PantoYT/wled-controller/enclosure/rev1/renders/enclosure-base-outputs.png

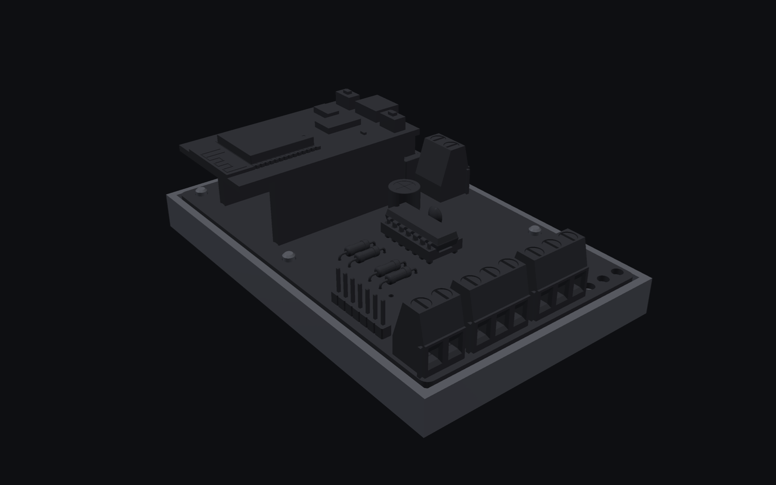
enclosure/rev1/renders/enclosure-base-outputs.png
