PantoYT/wled-controller/enclosure/rev1/renders/enclosure-outputs.png

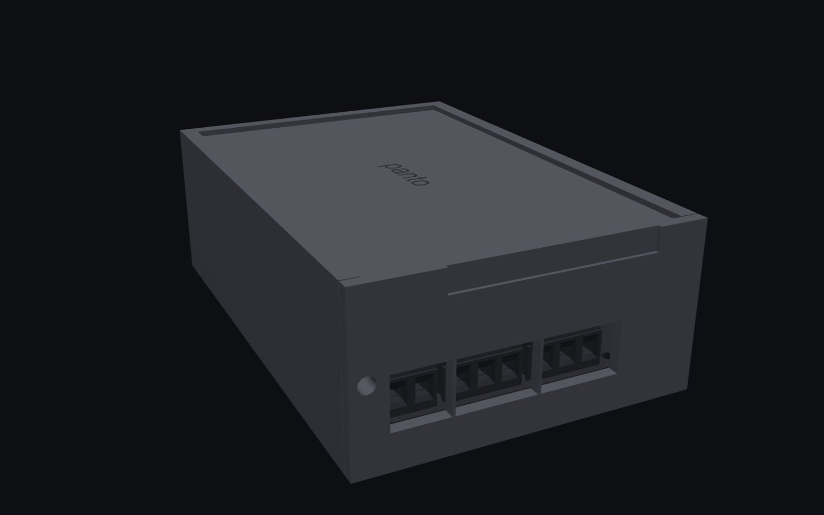
enclosure/rev1/renders/enclosure-outputs.png
