PantoYT/wled-controller/enclosure/rev1/renders/enclosure-top.png

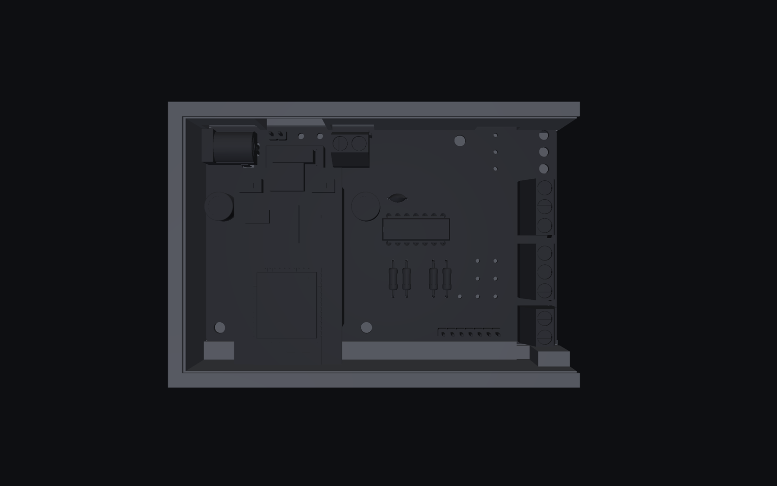
enclosure/rev1/renders/enclosure-top.png
