PantoYT/wled-controller/enclosure/wall/renders/wall-bottom.png

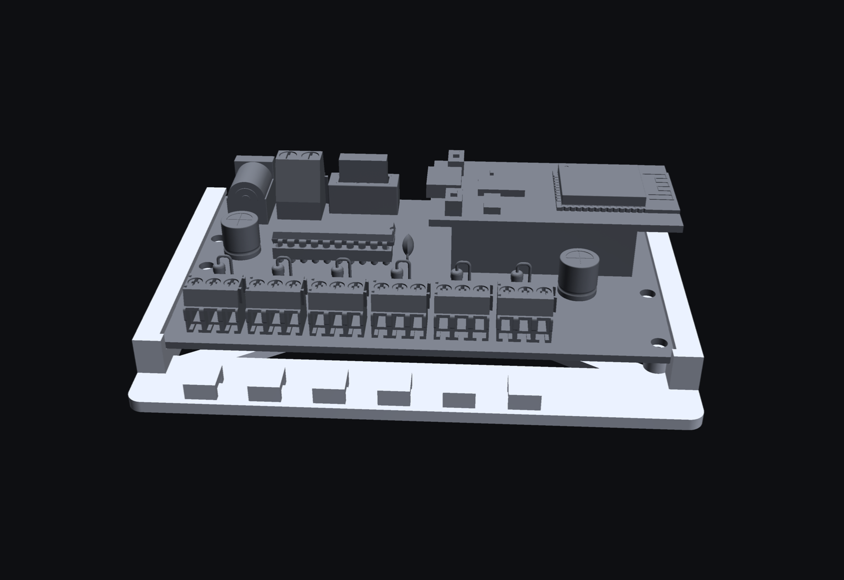
enclosure/wall/renders/wall-bottom.png
