PantoYT/wled-controller/enclosure/wall/renders/wall-front.png

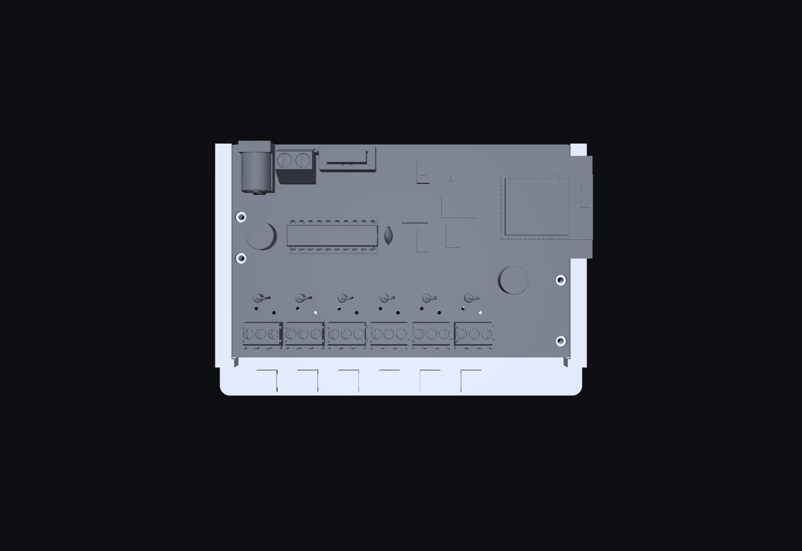
enclosure/wall/renders/wall-front.png
