PantoYT/wled-controller/rev2/renders/v2-wall-iso.png

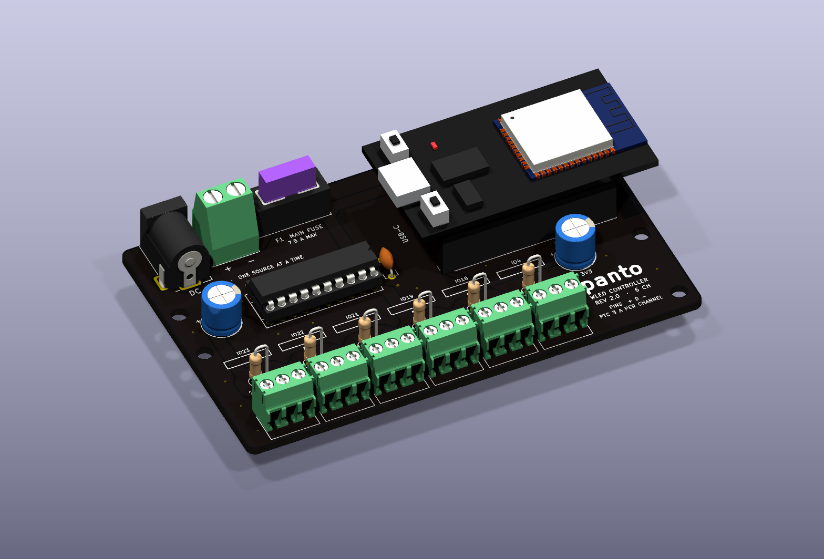
rev2/renders/v2-wall-iso.png
