PantoYT/wled-controller/purchases/wled-costs.xlsx

Sheet: v1 cost
Source | Item | Symbol | Qty | Unit PLN | Line PLN | Link | Note
JLCPCB | PCB rev 1.0, 2 layers, 5 pcs, shipping included |  | 5 |  | 30.00 | https://jlcpcb.com/ | paid
Allegro | ESP32-WROOM-32 USB-C CH340 4 MB |  | 1 |  | 25.00 | https://allegro.pl/oferta/mikrokontroler-esp-wroom-32-esp32-usb-c-ch340-wifi-bt-esp-32-4mb-do-arduino-12575360436 | paid
Allegro | WS2812B 5 V, 30 LED/m, IP30, black PCB |  | 4 |  | 40.00 | https://allegro.pl/oferta/1m-tasma-ws2812b-argb-5v-30-diod-m-ip30-smart-magic-led-czarne-pcb-18922593462 | paid, ~; 4 m = 120 LEDs, 72 used
Allegro | JST SM 3-pin pair (plug + socket) |  | 1 |  | 3.50 | https://allegro.pl/oferta/konektory-para-gniazdo-wtyk-jst-sm-3-pin-do-tasm-ws2812b-ws2811-rgb-17680312115 | paid
TME | 74HCT125 buffer DIP-14 | CD74HCT125E | 2 | 4.68 |  | https://www.tme.eu/pl/katalog/?search=CD74HCT125E | 1 on board #1, 1 spare
TME | DIP-14 socket | 1-2199298-3 | 1 | 1.27 |  | https://www.tme.eu/pl/katalog/?search=1-2199298-3
TME | Female header 1x40 (cut to 2x 1x15) | ZL262-40SG | 2 | 2.23 |  | https://www.tme.eu/pl/katalog/?search=ZL262-40SG
TME | 100 nF ceramic THT | CC-104/100 | 100 | 0.17 |  | https://www.tme.eu/pl/katalog/?search=CC-104%2F100 | TME minimum 100
TME | 100 ohm 0.25 W | CF1/4W-100R | 100 | 0.04 |  | https://www.tme.eu/pl/katalog/?search=CF1%2F4W-100R | TME minimum 100
TME | Mini blade fuse holder | KEYS3568 | 1 | 4.77 |  | https://www.tme.eu/pl/katalog/?search=KEYS3568
TME | Mini blade fuse 3 A | 0297003.WXNV | 2 | 1.71 |  | https://www.tme.eu/pl/katalog/?search=0297003.WXNV
TME | DC jack 5.5/2.1 THT | PC-GK2.1 | 3 | 1.75 |  | https://www.tme.eu/pl/katalog/?search=PC-GK2.1 | TME minimum 3
TME | Screw terminal 5.08 mm 3-pole | TB-5.08-P-3P/BL | 2 | 1.97 |  | https://www.tme.eu/pl/katalog/?search=TB-5.08-P-3P%2FBL
TME | Screw terminal 5.08 mm 2-pole | TB-5.08-P-2P/BL | 5 | 1.32 |  | https://www.tme.eu/pl/katalog/?search=TB-5.08-P-2P%2FBL | TME minimum 5
TME | Male header 1x40 | ZL201-40G | 10 | 1.42 |  | https://www.tme.eu/pl/katalog/?search=ZL201-40G | TME minimum 10
own | 1000 uF 16 V electrolytic (owned) | EEUFR1C102L | 2 | 0.00 |  | https://www.tme.eu/pl/katalog/?search=EEUFR1C102L | already owned; 3.95 each at TME
TME | Shipping |  | 1 |  |  |  | FILL IN from the invoice
Allegro | Shipping |  | 1 |  |  |  | FILL IN
 | TOTAL (fills in when shipping is entered)
 | TME subtotal
 | TME prices: catalogue on 2026-10-19 via API, not the invoice. Allegro/JLC: what Panto paid.

Sheet: v2 phi 6ch
Ref | Item | Symbol | Need | In inventory | Buy | Unit PLN | Line PLN | Link | Note
PCB | PCB rev 2.0 phi 100x61.8, 5 pcs, shipping included |  | 1 | 0 | 1 | 30.00 |  | https://jlcpcb.com/ | estimate = what rev 1.0 cost; upload v2 gerbers
U2/U3 module | ESP32-WROOM-32 USB-C CH340 30-pin |  | 1 | 0 | 1 | 25.00 |  | https://allegro.pl/oferta/mikrokontroler-esp-wroom-32-esp32-usb-c-ch340-wifi-bt-esp-32-4mb-do-arduino-12575360436 | inventory has no spare ESP32
U1 | 74HCT245 DIP-20 (HCT, not HC) | SN74HCT245N | 1 | 0 | 1 | 2.70 |  | https://www.tme.eu/pl/katalog/?search=SN74HCT245N
 | DIP-20 socket | 1-2199298-6 | 1 | 0 | 1 | 2.29 |  | https://www.tme.eu/pl/katalog/?search=1-2199298-6
F1 | Mini blade fuse holder | KEYS3568 | 1 | 0 | 1 | 4.77 |  | https://www.tme.eu/pl/katalog/?search=KEYS3568 | rev 1.0 one is soldered on board #1
F1 | Mini blade fuse 7.5 A max | 029707.5WXNV | 1 | 1 | 2 | 1.71 |  | https://www.tme.eu/pl/katalog/?search=029707.5WXNV | spare 3 A from inventory works for a small load
F11-F16 | Polyfuse 3 A hold, 16 V | RG300-16 | 6 | 0 | 6 | 1.36 |  | https://www.tme.eu/pl/katalog/?search=RG300-16
J11-J16 | Screw terminal 3.5 mm 3-pole | XY302R-3P-3.5-GN | 6 | 0 | 6 | 1.29 |  | https://www.tme.eu/pl/katalog/?search=XY302R-3P-3.5-GN | check holes vs Phoenix footprint
J21-J26 | JST XH 3-pin socket | B3B-XH-A | 6 | 0 | 6 | 0.50 |  | https://www.tme.eu/pl/katalog/?search=B3B-XH-A
R1-R6 | 100 ohm 0.25 W | CF1/4W-100R | 6 | 96 | 0 | 0.04 |  | https://www.tme.eu/pl/katalog/?search=CF1%2F4W-100R | from inventory
C1, C2 | 1000 uF 16 V, D8 P5 | EEUFR1C102L | 2 | 2 | 0 | 3.95 |  | https://www.tme.eu/pl/katalog/?search=EEUFR1C102L | from inventory
C3 | 100 nF ceramic | CC-104/100 | 1 | 99 | 0 | 0.17 |  | https://www.tme.eu/pl/katalog/?search=CC-104%2F100 | from inventory
J1 | DC jack 5.5/2.1 | PC-GK2.1 | 1 | 2 | 0 | 1.75 |  | https://www.tme.eu/pl/katalog/?search=PC-GK2.1 | from inventory
J2 | Screw terminal 5.08 mm 2-pole | TB-5.08-P-2P/BL | 1 | 3 | 0 | 1.32 |  | https://www.tme.eu/pl/katalog/?search=TB-5.08-P-2P%2FBL | from inventory
U2, U3 | Female header 1x40 (cut to 2x 1x15) | ZL262-40SG | 2 | 0 | 2 | 2.23 |  | https://www.tme.eu/pl/katalog/?search=ZL262-40SG | rev 1.0 spare not in inventory: CHECK drawer, then set buy to 0
strips | JST SM to XH lead, or wire straight into the terminal |  | 6 | 0 | 0 |  |  |  | not at TME; optional
 | TME shipping |  | 1 | 0 | 1 |  |  |  | FILL IN
 | TO BUY (PCB + ESP32 + TME parts)
 | Value taken from inventory
 | In inventory = quantity in parts-inventory/inventory.xlsx on 2026-10-19. Strip not included (48 LEDs left over).

Sheet: leftovers
Item (inventory.xlsx) | Qty
WLED controller PCB v1, bare | 4
WS2812B strip, leftover | 48
100 ohm | 96
Ceramic 100 nF (104) | 99
Electrolytic 1000 uF 16 V | 2
DC barrel jack | 2
Screw terminal, 2 poles | 3
Mini blade fuse 3 A | 1
CD74HCT125E
DIP-14 socket
Male pin header 1x16 | 9

Sheet: files
What | Where
v1 gerbers | E:\Pliki\Projects\wled-controller\wled-controller-gerbers.zip
v2 phi gerbers | E:\Pliki\Projects\wled-controller\v2\wled-controller-v2-phi-gerbers.zip
v1 TME quickbuy | E:\Pliki\Projects\wled-controller\quickbuy-v1.txt
v2 TME quickbuy | E:\Pliki\Projects\wled-controller\v2\quickbuy-v2-phi.txt
JLCPCB order page | https://jlcpcb.com/
TME quick buy | https://www.tme.eu/pl/ (koszyk -> szybkie zakupy / import listy)
