PantoYT/wled-controller/rev1/BOM.md

# Bill of materials

TME symbols and prices (PLN gross) as seen in the TME cart on 2026-10-02.

| Ref | Part | TME symbol | Qty to order | Note |
|---|---|---|---|---|
| U1 | 74HCT125 buffer, DIP-14 (HCT/AHCT only, not HC) | `CD74HCT125E` | 2 | 4.69 each; one spare |
| — | DIP-14 socket | `1-2199298-3` | 1 | 1.28 |
| U2, U3 | Female header 1×40, cut into two 1×15 | `ZL262-40SG` | 2 (minimum) | 1.86 each, 10 890 in stock; true 1×15 parts at TME are 7 PLN+ or 1000-piece MOQ |
| J4, J16 | Male pin header 1×40 | `DS1021-1*40SF11-B` | 10 (minimum) | break into 1×2 and 1×7 |
| C1, C2 | 1000 µF 16 V electrolytic, Ø8 mm, 5 mm pitch | — | 2 | already owned |
| C3 | 100 nF ceramic, THT, 5 mm pitch | `CC-104/100` | 100 (minimum) | |
| R1–R4 | 100 Ω 0.25 W carbon film | `CF1/4W-100R` | 100 (minimum) | |
| F1 | Mini blade fuse holder | `KEYS3568` | 1 | |
| — | Mini blade fuse 3 A | `0297003.WXNV` | 2 | Littelfuse MINI |
| J1 | DC jack 5.5/2.1 mm, right angle, THT | `PC-GK2.1` | 3 (minimum) | Out of stock on 2026-10-02, TME expects 2026-10-21. The footprint is made for this exact part (`footprints/wled.pretty`). |
| J6, J7 | Screw terminal 5.08 mm, 3-pole | `TB-5.08-P-3P/BL` | 2 | |
| J2, J8 | Screw terminal 5.08 mm, 2-pole | `TB-5.08-P-2P/BL` | 2+ | |
| J5 | JST SM 3-pin pigtail pair | — | 1 | not at TME; Allegro |

## PCB

JLCPCB: 5 boards, 2 layers, up to 100 × 100 mm, standard options: 2 USD. Mask colour does
not change the price. Shipping to Poland and import VAT come on top.
