PantoYT/wled-controller/3d/fuse_mini.step

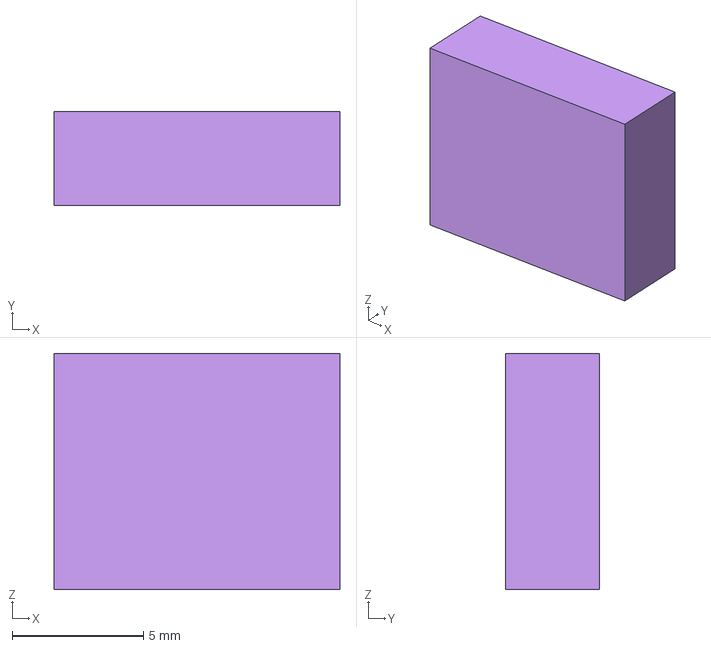
[picture p20: CAD file, 2026-10-20]
3d/fuse_mini.step
10.9 x 3.60 x 9.00 mm
