PantoYT/wled-controller/enclosure/rev1/lid.stl

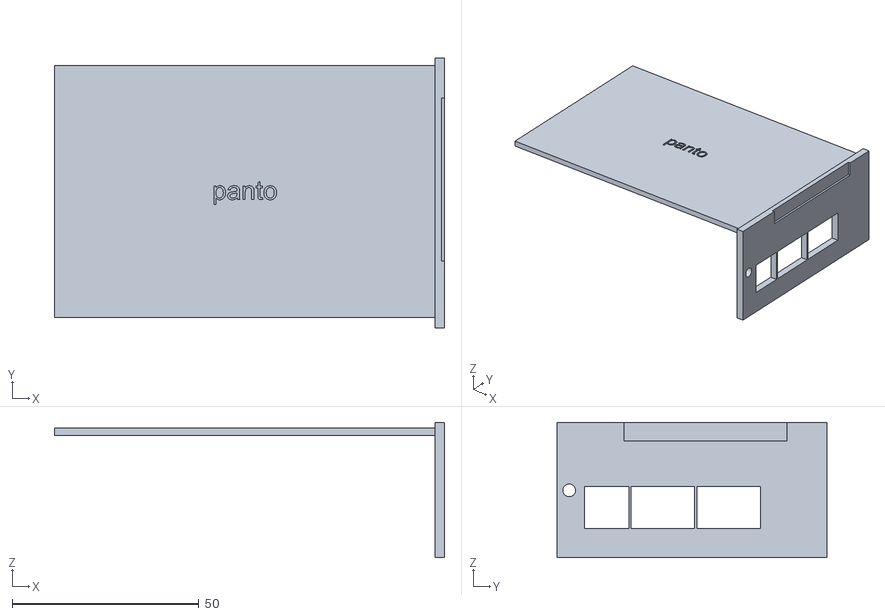
[picture p21: CAD file, 2026-10-20]
enclosure/rev1/lid.stl
104.5 x 72.4 x 36.2
