PantoYT/wled-controller/enclosure/wall/wall-fit-test.stl

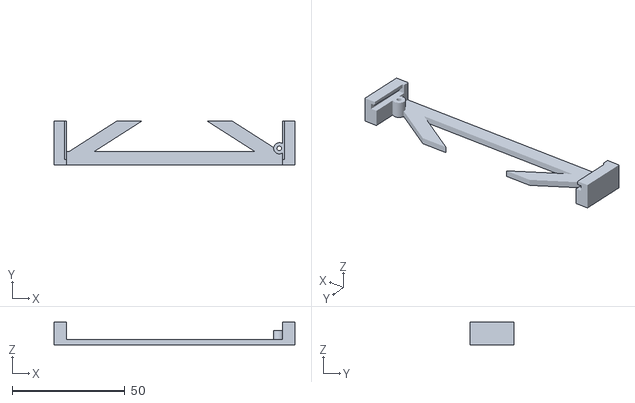
[picture p22: CAD file, 2026-10-29]
enclosure/wall/wall-fit-test.stl
107.0 x 19.4 x 10.0
