PantoYT/wled-controller/rev2/wled-controller-v2-wall.step

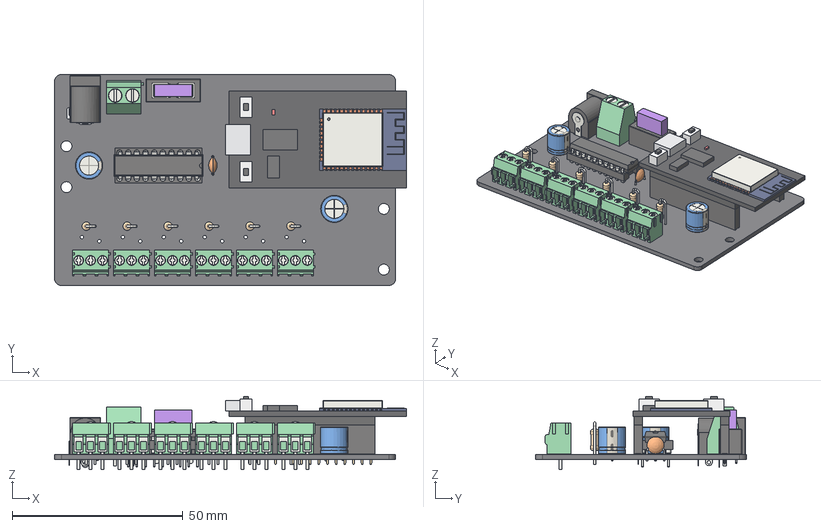
[picture p23: CAD file, 2026-10-20]
rev2/wled-controller-v2-wall.step
103.2 x 61.8 x 21.4 mm
BarrelJack_Horizontal
PinSocket_1x15_P2.54mm_Vertical x 2
TerminalBlock_Phoenix_PT-1,5-3-3.5-H_1x03_P3.50mm_Horizontal x 6
CP_Radial_D80mm_P500mm x 2
header_spacer x 2
devkit_pcb
ESP32-WROOM-32
usb_c
button x 2
button_cap x 2
ch340
ldo
led
DIP_20_W762mm_Socket
DIP-20_W7.62mm
A_Keystone_3568
fuse_mini
R_Axial_DIN0207_L63mm_D25mm_P254mm_Vertical x 6
C_Disc_D50mm_W25mm_P500mm
TerminalBlock_Phoenix_MKDS-1,5-2-5.08_1x02_P5.08mm_Horizontal
wled-controller-v2-wall_PCB
