PantoYT/wled-controller/3d/header_spacer.step

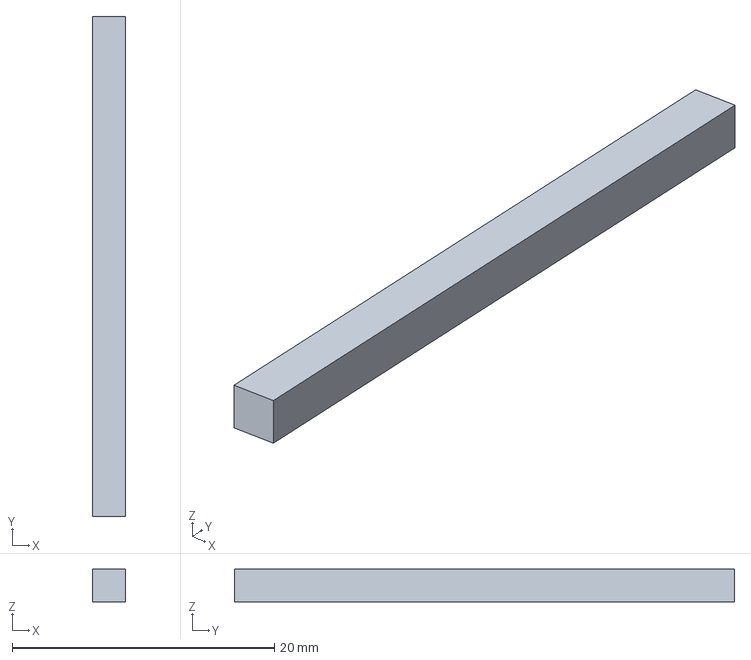
[picture p24: CAD file, 2026-10-20]
3d/header_spacer.step
2.54 x 38.1 x 2.50 mm
