PantoYT/wled-controller/enclosure/rev1/body.stl

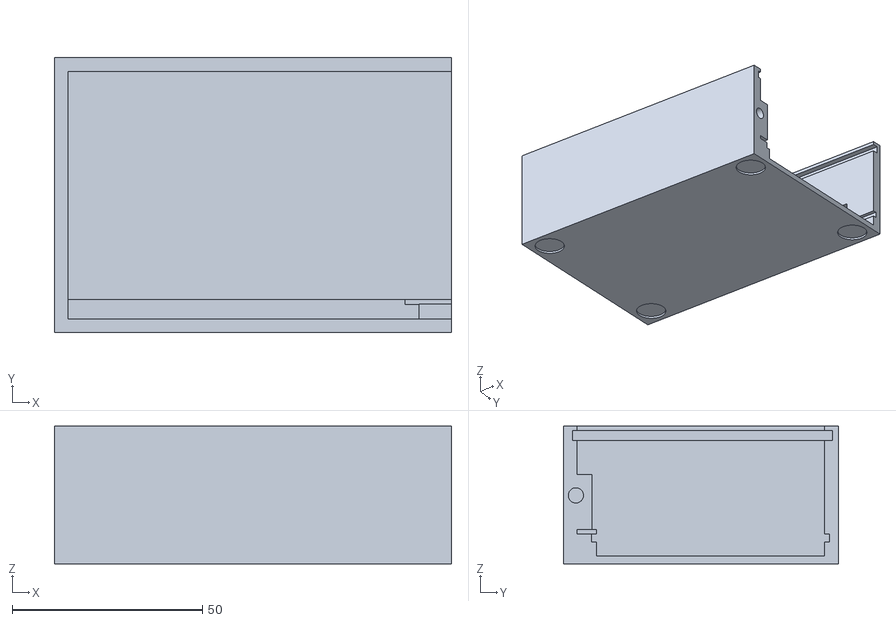
[picture p25: CAD file, 2026-10-20]
enclosure/rev1/body.stl
104.4 x 72.4 x 36.2
