PantoYT/wled-controller/enclosure/wall/wall.step

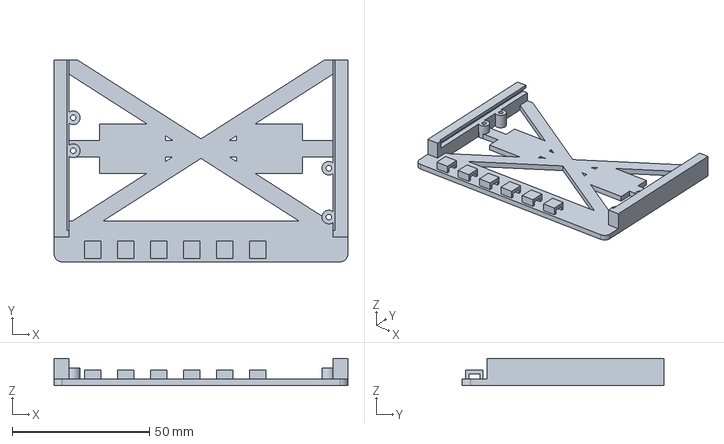
[picture p26: CAD file, 2026-10-29]
enclosure/wall/wall.step
107.0 x 73.5 x 10.0 mm
