PantoYT/wled-controller/3d/ch340.step

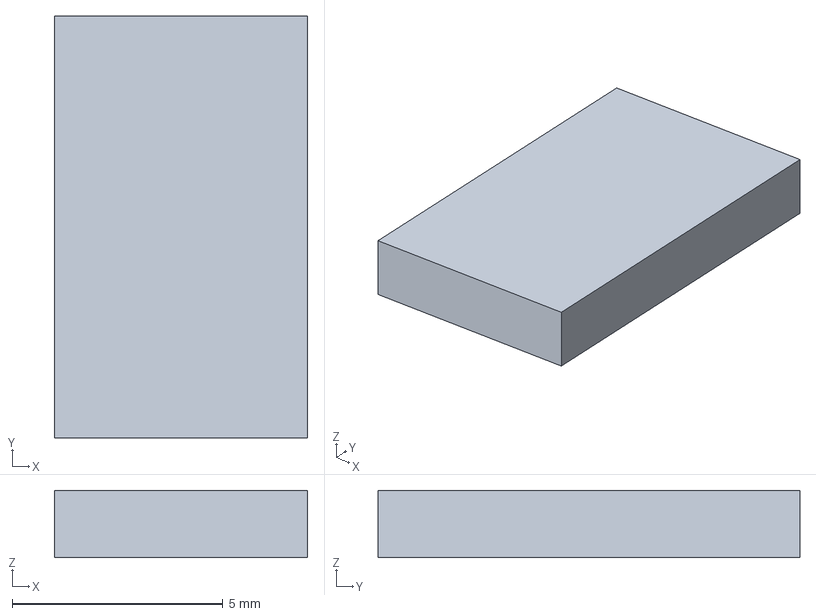
[picture p27: CAD file, 2026-10-20]
3d/ch340.step
6.00 x 10.0 x 1.60 mm
