PantoYT/wled-controller/enclosure/rev1/enclosure.step

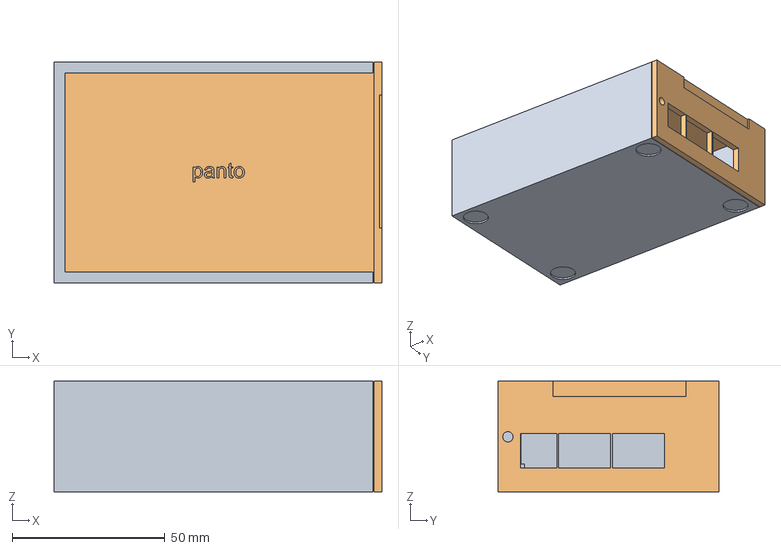
[picture p28: CAD file, 2026-10-20]
enclosure/rev1/enclosure.step
107.3 x 72.4 x 36.2 mm
