PantoYT/wled-controller/3d/button_cap.step

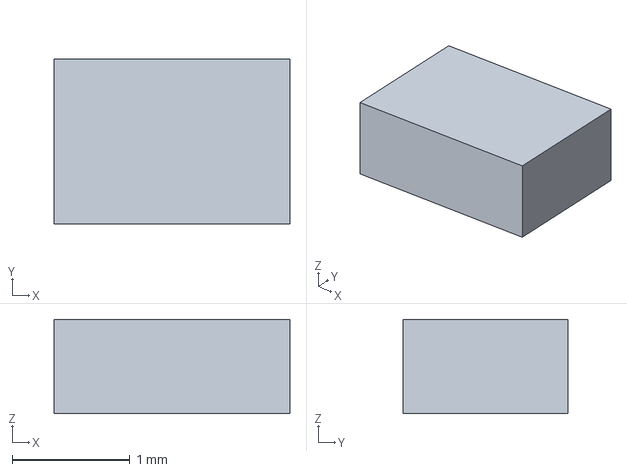
[picture p29: CAD file, 2026-10-20]
3d/button_cap.step
2.00 x 1.40 x 0.8 mm
