PantoYT/wled-controller/enclosure/rev1/fit-test-lid.stl

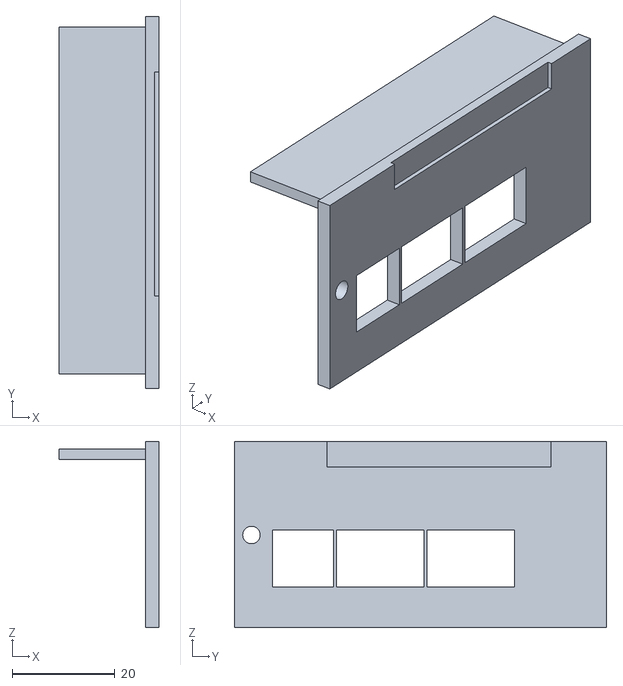
[picture p30: CAD file, 2026-10-20]
enclosure/rev1/fit-test-lid.stl
19.4 x 72.4 x 36.2
