PantoYT/wled-controller/3d/ldo.step

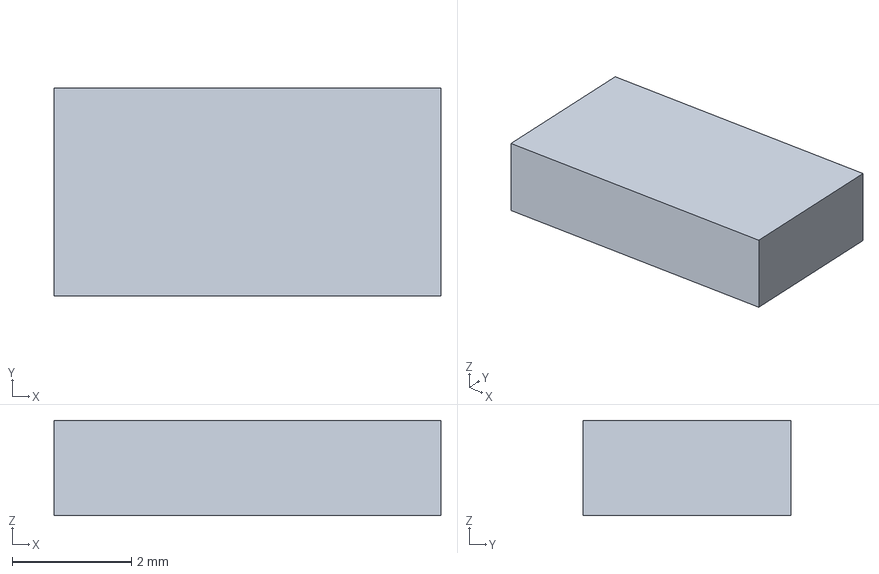
[picture p31: CAD file, 2026-10-20]
3d/ldo.step
6.50 x 3.50 x 1.60 mm
