PantoYT/wled-controller/enclosure/rev1/base.step

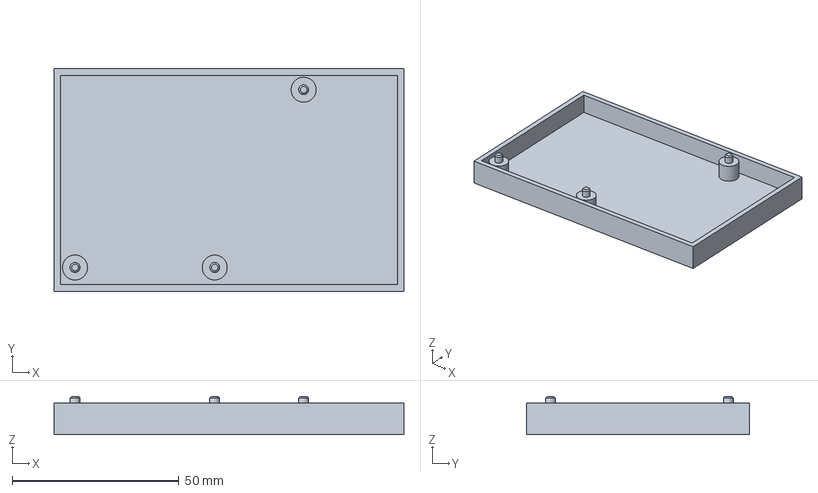
[picture p32: CAD file, 2026-10-20]
enclosure/rev1/base.step
105.0 x 66.8 x 11.5 mm
