PantoYT/wled-controller/3d/led.step

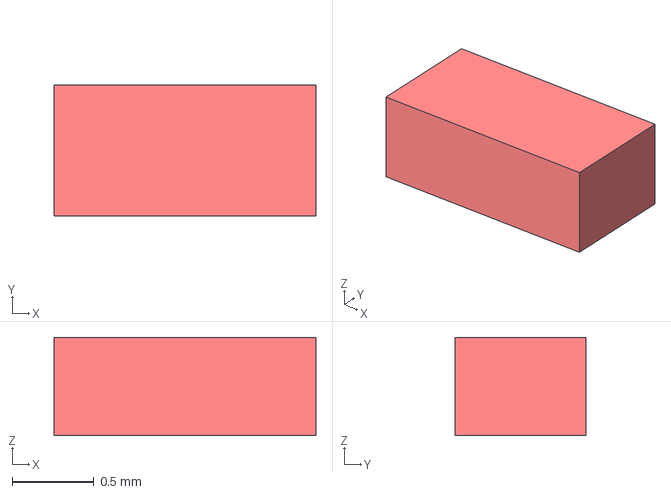
[picture p33: CAD file, 2026-10-20]
3d/led.step
1.60 x 0.8 x 0.6 mm
