PantoYT/wled-controller/enclosure/rev1/fit-test-body.stl

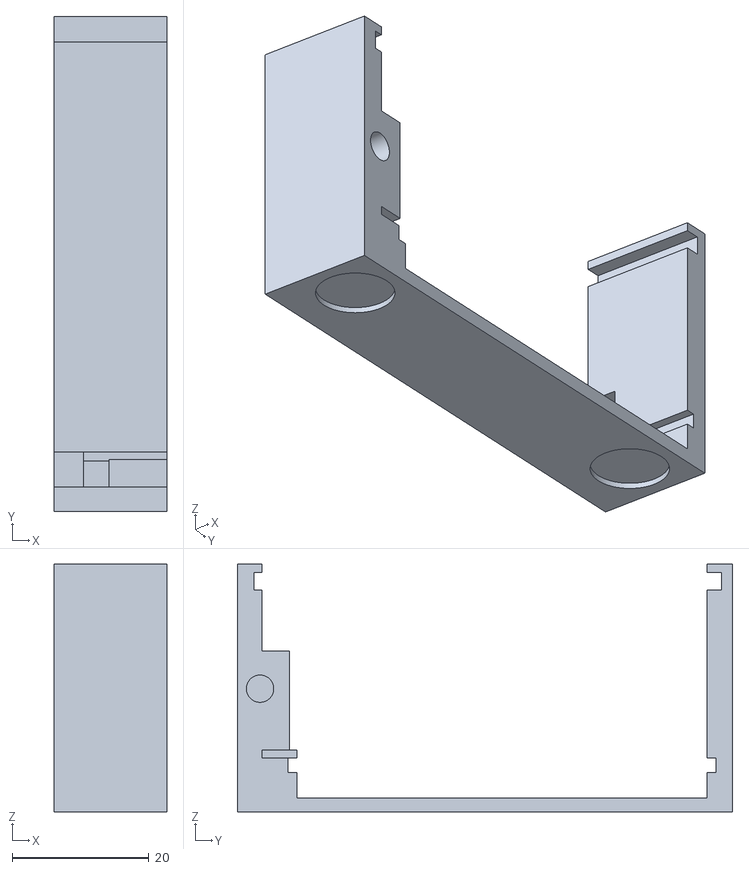
[picture p34: CAD file, 2026-10-20]
enclosure/rev1/fit-test-body.stl
16.5 x 72.4 x 36.2
