PantoYT/wled-controller/3d/devkit_pcb.step

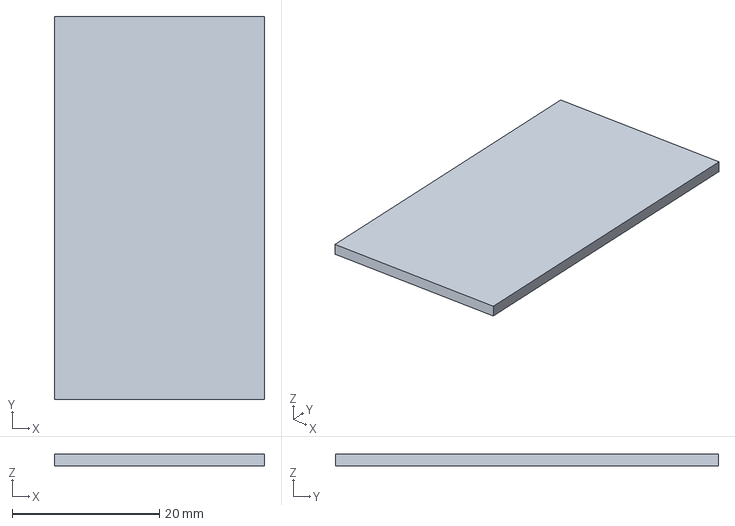
[picture p35: CAD file, 2026-10-20]
3d/devkit_pcb.step
28.5 x 52.0 x 1.60 mm
