PantoYT/wled-controller/3d/usb_c.step

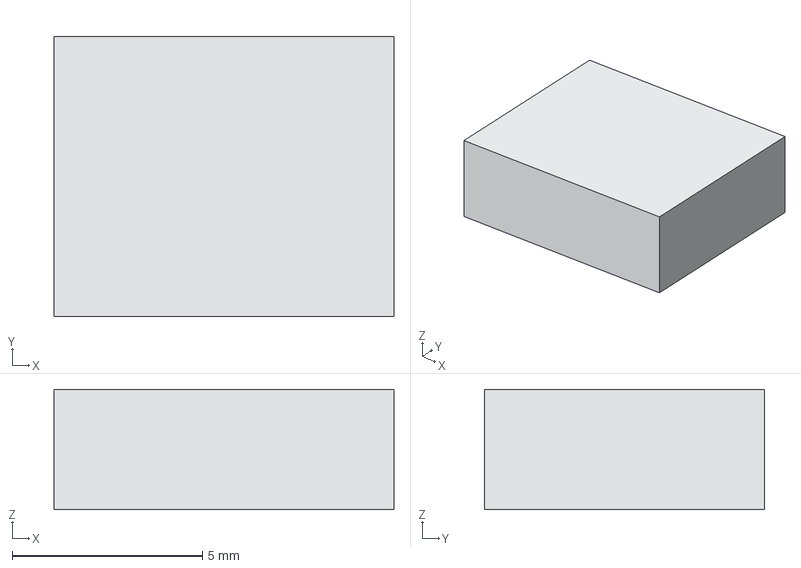
[picture p36: CAD file, 2026-10-20]
3d/usb_c.step
8.94 x 7.35 x 3.16 mm
