PantoYT/wled-controller/3d/button.step

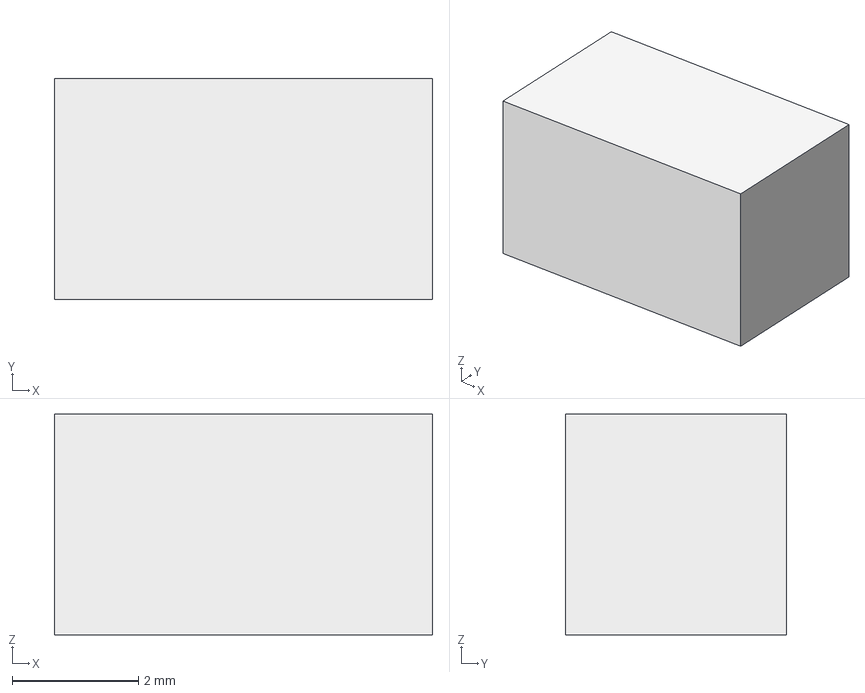
[picture p37: CAD file, 2026-10-20]
3d/button.step
6.00 x 3.50 x 3.50 mm
