PantoYT/wled-controller/(list of files, cad)

Other CAD files:
enclosure/rev1/base.3mf
enclosure/rev1/base.stl
enclosure/wall/wall.stl
rev1/wled-controller.step
rev2/old-variants/wled-controller-v2-phi4.step
