PantoYT/wled-controller/rev2/old-variants/wled-controller-v2-100.kicad_pcb

## KiCad design rev2/old-variants/wled-controller-v2-100.kicad_pcb (2026-10-20, an earlier design)

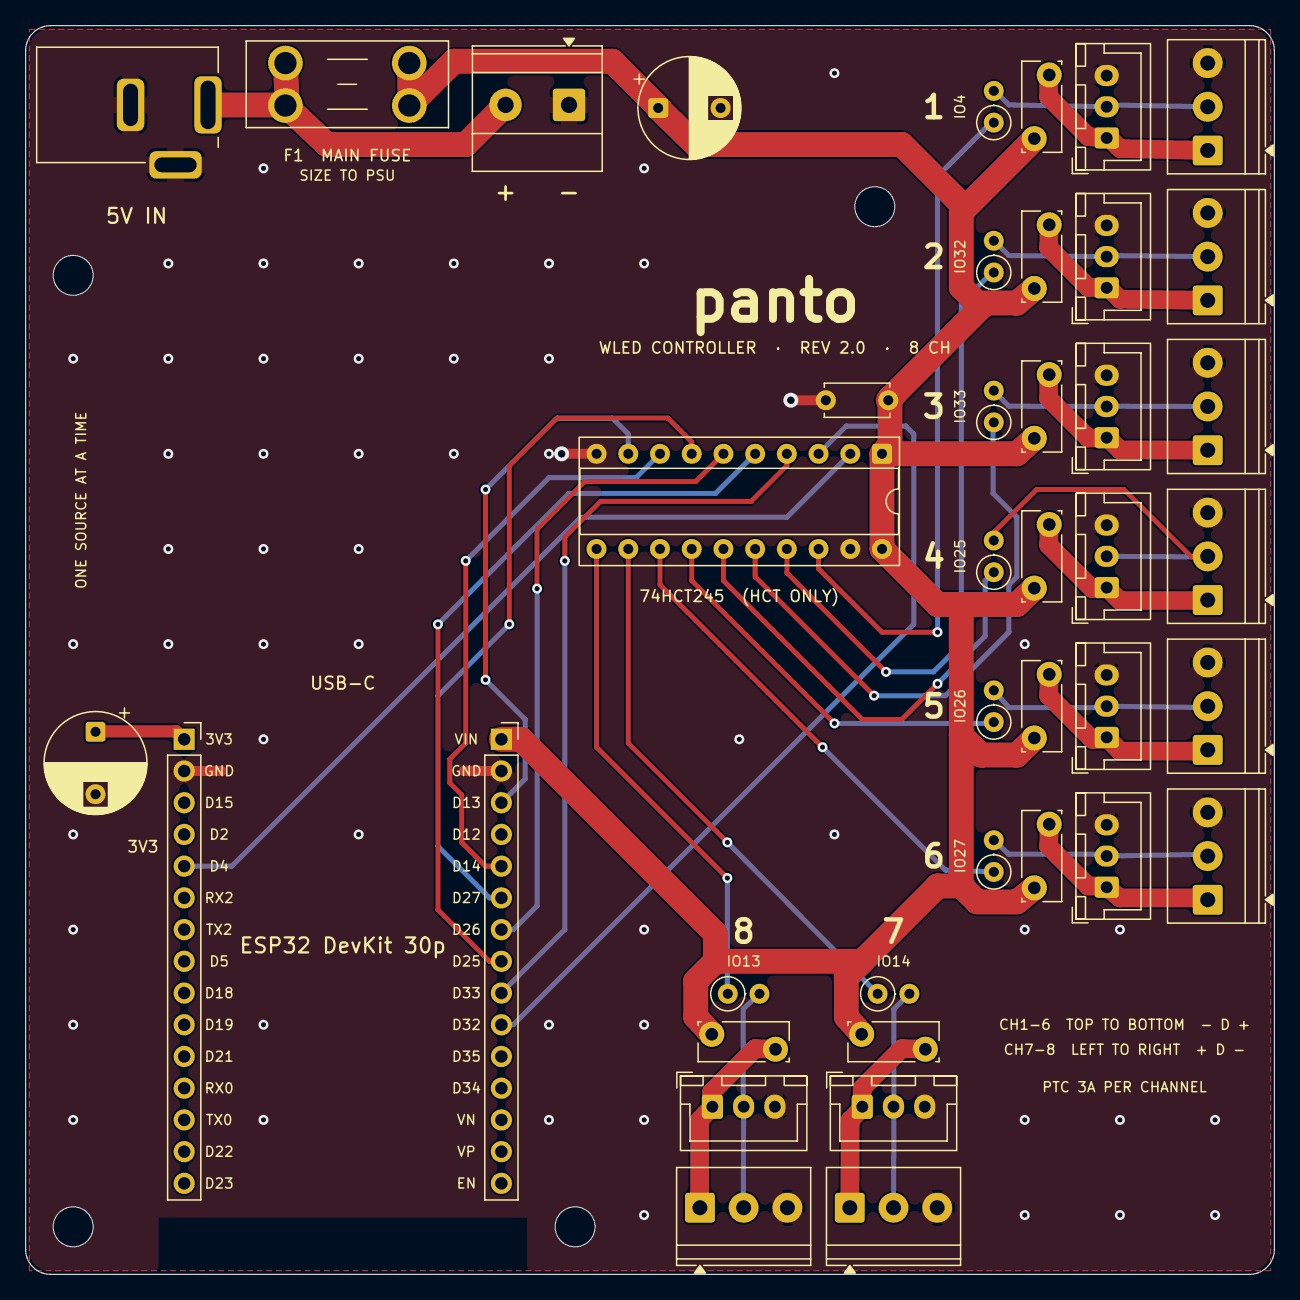
[picture p39: board wled-controller-v2-100.kicad_pcb from above]

Board: 2 copper layers, 100.0 x 100.0 mm, 46 parts (0 on the bottom side), 36 nets.

Parts:
C1, C2: 1000uF 16V; CP_Radial_D8.0mm_P5.00mm
C3: 100nF; C_Disc_D5.0mm_W2.5mm_P5.00mm
ESP1: ESP32 DevKit (3D only)
F1: Mini blade fuse, size to the PSU; Fuseholder_Blade_Mini_Keystone_3568
F11, F12, F13, F14, F15, F16, F17, F18: MF-RG300 3A; Fuse_Bourns_MF-RG300
H1, H2, H3, H4: M3; MountingHole_3.2mm_M3
J1: PC-GK2.1; DC_Jack_Ninigi_PC-GK2.1
J2: Screw 2p IN; TerminalBlock_Phoenix_MKDS-1,5-2-5.08_1x02_P5.08mm_Horizont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
J11: Screw CH1; TerminalBlock_Phoenix_PT-1,5-3-3.5-H_1x03_P3.50mm_Horizontal
J12: Screw CH2; TerminalBlock_Phoenix_PT-1,5-3-3.5-H_1x03_P3.50mm_Horizontal
J13: Screw CH3; TerminalBlock_Phoenix_PT-1,5-3-3.5-H_1x03_P3.50mm_Horizontal
J14: Screw CH4; TerminalBlock_Phoenix_PT-1,5-3-3.5-H_1x03_P3.50mm_Horizontal
J15: Screw CH5; TerminalBlock_Phoenix_PT-1,5-3-3.5-H_1x03_P3.50mm_Horizontal
J16: Screw CH6; TerminalBlock_Phoenix_PT-1,5-3-3.5-H_1x03_P3.50mm_Horizontal
J17: Screw CH7; TerminalBlock_Phoenix_PT-1,5-3-3.5-H_1x03_P3.50mm_Horizontal
J18: Screw CH8; TerminalBlock_Phoenix_PT-1,5-3-3.5-H_1x03_P3.50mm_Horizontal
J21: JST-XH CH1; JST_XH_B3B-XH-A_1x03_P2.50mm_Vertical
J22: JST-XH CH2; JST_XH_B3B-XH-A_1x03_P2.50mm_Vertical
J23: JST-XH CH3; JST_XH_B3B-XH-A_1x03_P2.50mm_Vertical
J24: JST-XH CH4; JST_XH_B3B-XH-A_1x03_P2.50mm_Vertical
J25: JST-XH CH5; JST_XH_B3B-XH-A_1x03_P2.50mm_Vertical
J26: JST-XH CH6; JST_XH_B3B-XH-A_1x03_P2.50mm_Vertical
J27: JST-XH CH7; JST_XH_B3B-XH-A_1x03_P2.50mm_Vertical
J28: JST-XH CH8; JST_XH_B3B-XH-A_1x03_P2.50mm_Vertical
R1, R2, R3, R4, R5, R6, R7, R8: 100R; R_Axial_DIN0207_L6.3mm_D2.5mm_P2.54mm_Vertical
U1: 74HCT245; DIP-20_W7.62mm_Socket
U2, U3: ESP32 socket; PinSocket_1x15_P2.54mm_Vertical

Connections:
+3V3: C2.1, U2.1
+5V: C1.1, C3.1, F1.2, F11.1, F12.1, F13.1, F14.1, F15.1, F16.1, F17.1, F18.1, U1.1, U1.20, U3.1
DATA1: J11.2, J21.2, R1.2
DATA2: J12.2, J22.2, R2.2
DATA3: J13.2, J23.2, R3.2
DATA4: J14.2, J24.2, R4.2
DATA5: J15.2, J25.2, R5.2
DATA6: J16.2, J26.2, R6.2
DATA7: J17.2, J27.2, R7.2
DATA8: J18.2, J28.2, R8.2
GND: C1.2, C2.2, C3.2, J1.2, J1.3, J2.1, J11.3, J12.3, J13.3, J14.3, J15.3, J16.3, J17.3, J18.3, J21.3, J22.3, J23.3, J24.3, J25.3, J26.3, J27.3, J28.3, U1.10, U1.19, U2.2, U3.2
IO_CH1: U1.2, U2.5
IO_CH2: U1.3, U3.10
IO_CH3: U1.4, U3.9
IO_CH4: U1.5, U3.8
IO_CH5: U1.6, U3.7
IO_CH6: U1.7, U3.6
IO_CH7: U1.8, U3.5
IO_CH8: U1.9, U3.3
OUT1_RAW: R1.1, U1.18
OUT2_RAW: R2.1, U1.17
OUT3_RAW: R3.1, U1.16
OUT4_RAW: R4.1, U1.15
OUT5_RAW: R5.1, U1.14
OUT6_RAW: R6.1, U1.13
OUT7_RAW: R7.1, U1.12
OUT8_RAW: R8.1, U1.11
VIN_RAW: F1.1, J1.1, J2.2
V_CH1: F11.2, J11.1, J21.1
V_CH2: F12.2, J12.1, J22.1
V_CH3: F13.2, J13.1, J23.1
V_CH4: F14.2, J14.1, J24.1
V_CH5: F15.2, J15.1, J25.1
V_CH6: F16.2, J16.1, J26.1
V_CH7: F17.2, J17.1, J27.1
V_CH8: F18.2, J18.1, J28.1
