PantoYT/wled-controller/rev1/wled-controller.unrouted.kicad_pcb

## KiCad design rev1/wled-controller.unrouted.kicad_pcb (2026-10-20, an earlier design)

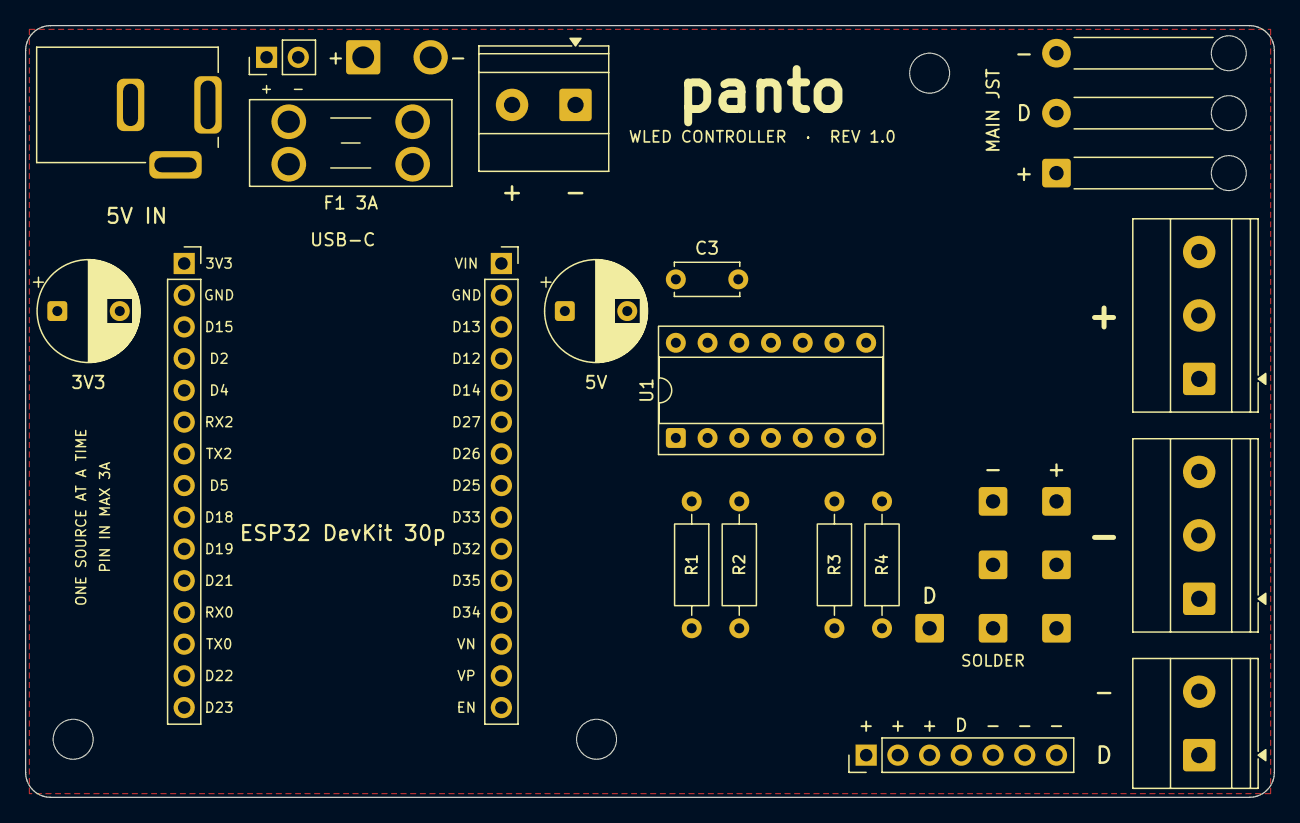
[picture p40: board wled-controller.unrouted.kicad_pcb from above]

Board: 2 copper layers, 100.0 x 61.8 mm, 31 parts (0 on the bottom side), 13 nets, no tracks yet.

Parts:
C1, C2: 1000uF 16V; CP_Radial_D8.0mm_P5.00mm
C3: 100nF; C_Disc_D5.0mm_W2.5mm_P5.00mm
ESP1: ESP32 DevKit (3D only)
F1: Fuse 3A (mini blade); Fuseholder_Blade_Mini_Keystone_3568
H1, H2, H3: M3; MountingHole_3.2mm_M3
J1: PC-GK2.1; DC_Jack_Ninigi_PC-GK2.1
J2: Screw 2p IN; TerminalBlock_Phoenix_MKDS-1,5-2-5.08_1x02_P5.08mm_Horizont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
J3: Solder IN; SolderWire-1sqmm_1x02_P5.4mm_D1.4mm_OD2.7mm
J4: Pin IN; PinHeader_1x02_P2.54mm_Vertical
J5: JST SM pigtail MAIN; SolderWire-0.5sqmm_1x03_P4.8mm_D0.9mm_OD2.3mm_Relief
J6: Screw 3p +; TerminalBlock_Phoenix_MKDS-1,5-3-5.08_1x03_P5.08mm_Horizont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
J7: Screw 3p -; TerminalBlock_Phoenix_MKDS-1,5-3-5.08_1x03_P5.08mm_Horizont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
J8: Screw D; TerminalBlock_Phoenix_MKDS-1,5-2-5.08_1x02_P5.08mm_Horizont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
J9: Solder D; SolderWire-0.5sqmm_1x01_D0.9mm_OD2.3mm
J10, J11, J12: Solder -; SolderWire-0.5sqmm_1x01_D0.9mm_OD2.3mm
J13, J14, J15: Solder +; SolderWire-0.5sqmm_1x01_D0.9mm_OD2.3mm
J16: Pin 7p; PinHeader_1x07_P2.54mm_Vertical
R1, R2, R3, R4: 100R; R_Axial_DIN0207_L6.3mm_D2.5mm_P10.16mm_Horizontal
U1: 74AHCT125; DIP-14_W7.62mm_Socket
U2, U3: ESP32 socket; PinSocket_1x15_P2.54mm_Vertical

Connections:
+3V3: C2.1, U2.1
+5V: C1.1, C3.1, F1.2, J5.1, J6.1, J6.2, J6.3, J13.1, J14.1, J15.1, J16.1, J16.2, J16.3, U1.14, U3.1
DATA1: J5.2, R4.2
DATA1_RAW: R4.1, U1.8
DATA2: J8.1, R2.2
DATA2_RAW: R2.1, U1.3
DATA3: J16.4, R1.2
DATA3_RAW: R1.1, U1.11
DATA4: J9.1, R3.2
DATA4_RAW: R3.1, U1.6
ESP_D4: U1.2, U1.5, U1.9, U1.12, U2.5
GND: C1.2, C2.2, C3.2, J1.2, J1.3, J2.1, J3.2, J4.2, J5.3, J7.1, J7.2, J7.3, J8.2, J10.1, J11.1, J12.1, J16.5, J16.6, J16.7, U1.1, U1.4, U1.7, U1.10, U1.13, U2.2, U3.2
VIN_RAW: F1.1, J1.1, J2.2, J3.1, J4.1
