PantoYT/wled-controller/rev2/old-variants/wled-controller-v2-phi4.kicad_pcb

## KiCad design rev2/old-variants/wled-controller-v2-phi4.kicad_pcb (2026-10-20, an earlier design)

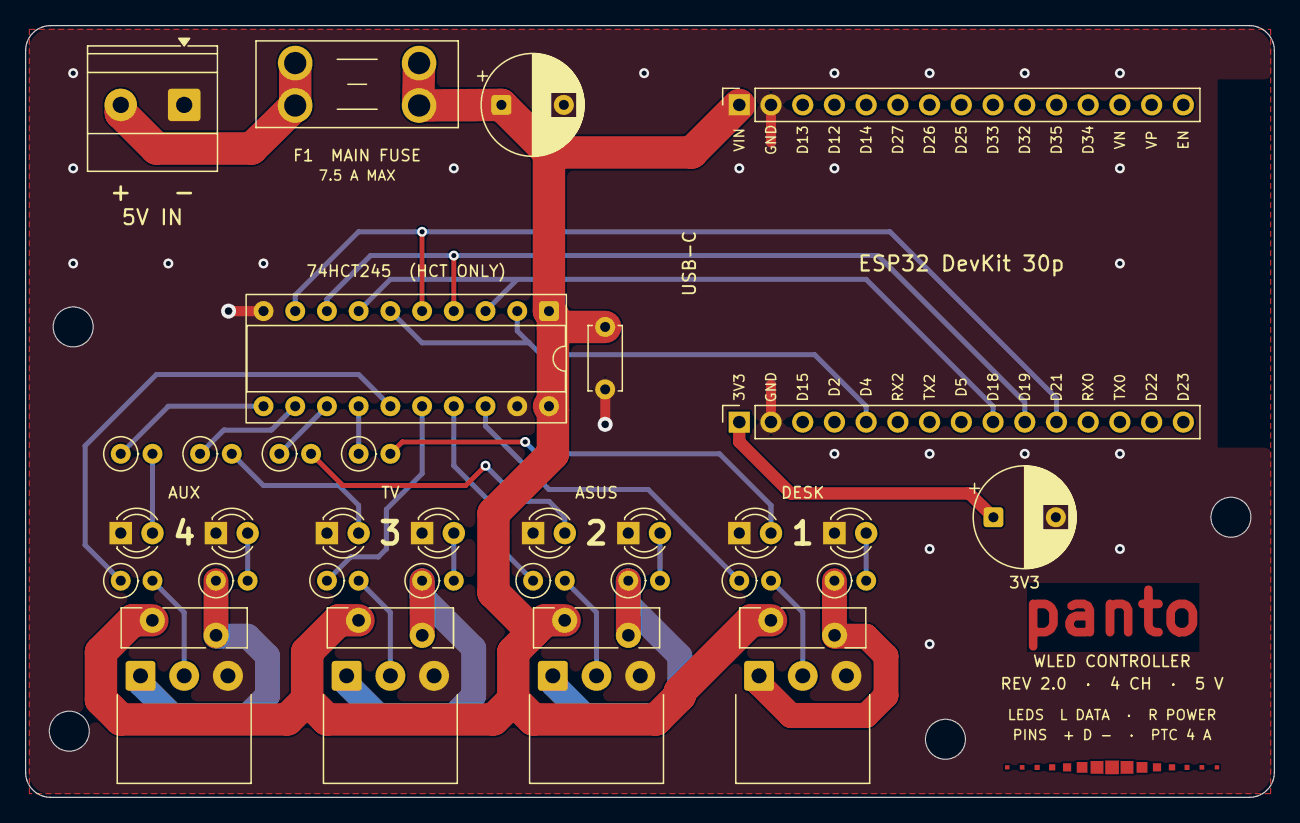
[picture p41: board wled-controller-v2-phi4.kicad_pcb from above]

Board: 2 copper layers, 100.0 x 61.8 mm, 41 parts (0 on the bottom side), 32 nets.

Parts:
C1, C2: 1000uF 16V; CP_Radial_D8.0mm_P5.00mm
C3: 100nF; C_Disc_D5.0mm_W2.5mm_P5.00mm
D11, D12, D13, D14: LED 3mm yellow (DATA); LED_D3.0mm
D21, D22, D23, D24: LED 3mm green (PWR); LED_D3.0mm
ESP1: ESP32 DevKit (3D only)
F1: Mini blade fuse, 7.5 A max; Fuseholder_Blade_Mini_Keystone_3568
F11, F12, F13, F14: RG400-16 4A; Fuse_Bourns_MF-RG400
H1, H2, H3, H4: M3; MountingHole_3.2mm_M3
J2: Screw 2p IN; TerminalBlock_Phoenix_MKDS-1,5-2-5.08_1x02_P5.08mm_Horizont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
J11: Screw CH1; TerminalBlock_Xinya_XY302R-3_P3.50mm_Horizontal
J12: Screw CH2; TerminalBlock_Xinya_XY302R-3_P3.50mm_Horizontal
J13: Screw CH3; TerminalBlock_Xinya_XY302R-3_P3.50mm_Horizontal
J14: Screw CH4; TerminalBlock_Xinya_XY302R-3_P3.50mm_Horizontal
R1, R2, R3, R4: 100R; R_Axial_DIN0207_L6.3mm_D2.5mm_P2.54mm_Vertical
R21, R22, R23, R24: 10k; R_Axial_DIN0207_L6.3mm_D2.5mm_P2.54mm_Vertical
R31, R32, R33, R34: 470R; R_Axial_DIN0207_L6.3mm_D2.5mm_P2.54mm_Vertical
U1: 74HCT245; DIP-20_W7.62mm_Socket
U2, U3: ESP32 socket; PinSocket_1x15_P2.54mm_Vertical

Connections:
+3V3: C2.1, U2.1
+5V: C1.1, C3.1, F1.2, F11.1, F12.1, F13.1, F14.1, U1.1, U1.20, U3.1
ACT1: R31.1, U1.14
ACT2: R32.1, U1.13
ACT3: R33.1, U1.12
ACT4: R34.1, U1.11
DATA1: J11.2, R1.2
DATA2: J12.2, R2.2
DATA3: J13.2, R3.2
DATA4: J14.2, R4.2
GND: C1.2, C2.2, C3.2, D11.1, D12.1, D13.1, D14.1, D21.1, D22.1, D23.1, D24.1, J2.1, J11.3, J12.3, J13.3, J14.3, U1.10, U1.19, U2.2, U3.2
IO_CH1: U1.2, U1.6, U2.5
IO_CH2: U1.3, U1.7, U2.9
IO_CH3: U1.4, U1.8, U2.10
IO_CH4: U1.5, U1.9, U2.11
LEDA1: D11.2, R31.2
LEDA2: D12.2, R32.2
LEDA3: D13.2, R33.2
LEDA4: D14.2, R34.2
OUT1_RAW: R1.1, U1.18
OUT2_RAW: R2.1, U1.17
OUT3_RAW: R3.1, U1.16
OUT4_RAW: R4.1, U1.15
PLED1: D21.2, R21.2
PLED2: D22.2, R22.2
PLED3: D23.2, R23.2
PLED4: D24.2, R24.2
VIN_RAW: F1.1, J2.2
V_CH1: F11.2, J11.1, R21.1
V_CH2: F12.2, J12.1, R22.1
V_CH3: F13.2, J13.1, R23.1
V_CH4: F14.2, J14.1, R24.1
