PantoYT/wled-controller/(commit log)

2026-10-20 wled-controller: rev 1.0, rev 2.0 wall board, wall mount
    Rev 1.0 (built), rev 2.0 'wall' (6 channels, ready to order, Gerbers in jlc/) with the
    dropped layouts in rev2/old-variants, the printed mounts with their collision checks,
    costs and TME lists, and docs/evolution.gif.
    [base.3mf, base.step, base.stl, body.stl, button.step, button_cap.step, ch340.step, devkit_pcb.step]
2026-10-20 Add the rev 2.0 schematic, checked against the board's nets
    rev2/schematic.py draws docs/schematic-wall.svg/.png from a net list; --check compares the
    list with the routed board pad by pad (28 nets, 0 differences).
2026-10-20 Take parts from TME or LCSC on the wall board
    One terminal footprint for XY302R and KF350, the fuse holder's drills opened to 1.9 mm for
    Keystone 3568 and XFCN XF-508P-B-B, the polyfuse row moved back for KF350's body; an LCSC BOM
    next to the TME list. DRC 0 / 0, schematic check 28 nets 0 differences, mount check 0 overlaps.
    [lcsc-bom-wall.csv, wled-controller-v2-wall.kicad_pcb, wled-controller-v2-wall.step]
2026-10-20 Revert "Take parts from TME or LCSC on the wall board"
    This reverts commit 341497ecf7fdd93901d9b4eab9d5328d5031ec81.
    [lcsc-bom-wall.csv, wled-controller-v2-wall.kicad_pcb, wled-controller-v2-wall.step]
2026-10-20 Back to TME parts only, keep the 74HCT245 / 74AHCT245 label
    Reverts the TME-or-LCSC footprints (Panto orders the parts from TME). The shifter's silkscreen
    now names both HCT and AHCT, since the AHCT part is the one being bought. DRC 0 / 0, schematic
    check 28 nets 0 differences, mount check 0 overlaps.
    [wled-controller-v2-wall.kicad_pcb, wled-controller-v2-wall.step]
2026-10-29 Wall mount: M2 screw holes in the posts, tape bar through the X
    Each post gets a 1.7 mm hole through for an M2 x 8 (the board's holes are 3.2 mm, the head
    rests on the board); the middle bar now crosses the X where the diagonals meet. Mount check:
    0 overlaps in place and while sliding in.
    [wall-fit-test.stl, wall.step, wall.stl]
2026-10-29 Wall mount: looser grooves after the first PETG fit test
    0.2 mm play per side and a 1.9 mm groove spread the rails and stopped the board short of the
    stops; now 0.5 mm per side and 2.2 mm, closing to 2.0 mm at the bottom. Mount check 0 overlaps.
    [wall-fit-test.stl, wall.step, wall.stl]
2026-10-29 Wall mount: 2.0 mm screw holes (1.7 printed too small for an M2 tap in PETG)
    [wall-fit-test.stl, wall.step, wall.stl]
